SvenHaedrich/kicad_dali_usb_lpc/README.md

KiCad Project for DALI to USB interface based on NXP LPC 1114 µController.

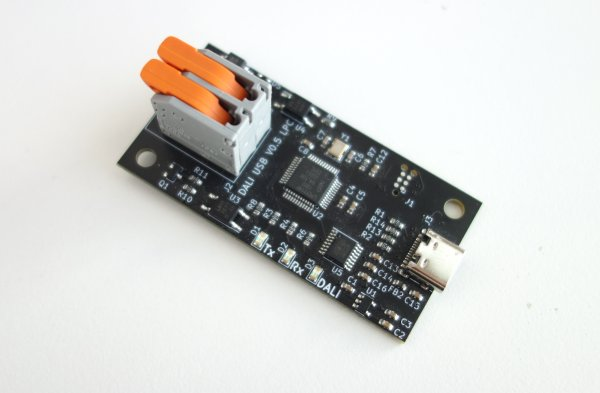
[picture p1: docs/DSC06797.JPG]
