SvenHaedrich/kicad_dali_usb_lpc/docs/transient_times.odt

Observed signal transient times are in the order of 10 ns. Both for falling and rising edges.

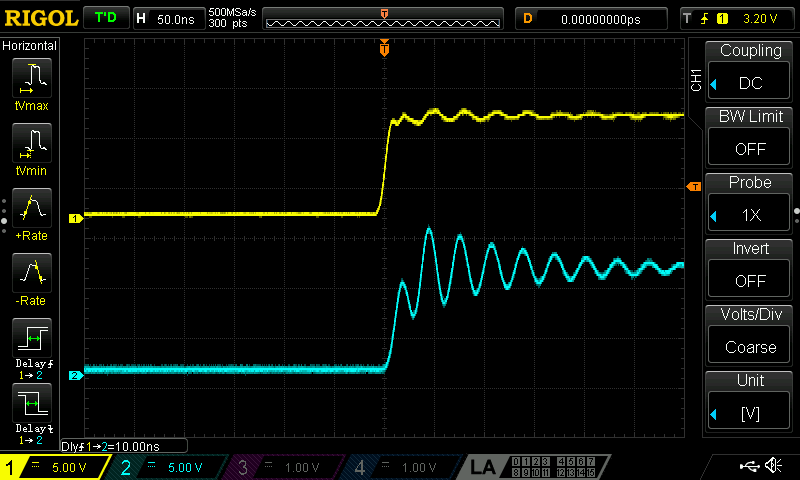
[picture p2: figure]

Figure 1: Rising edge test. Channel 1: signal generator. Channel 2: Testec probe.

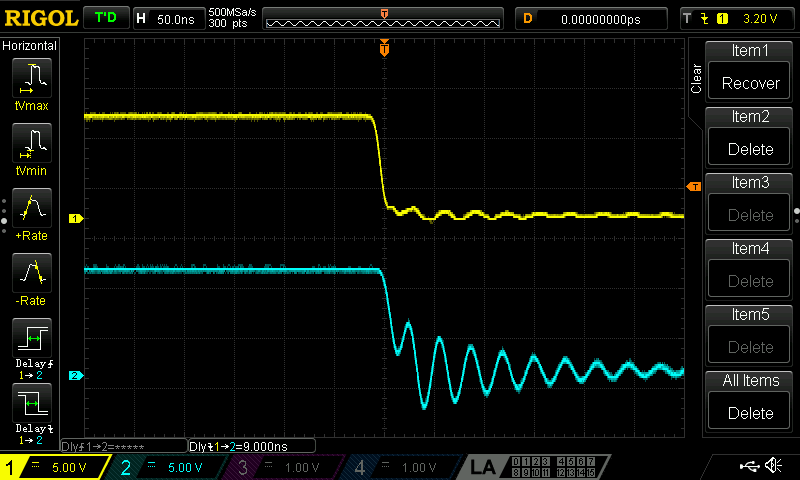
[picture p3: figure]

Figure 2: Falling edge test. Channel 1: signal generator, Channel 2: Testec probe

Rx transient times: falling edge: 21.8 µs, rising edge: 4.15 µs

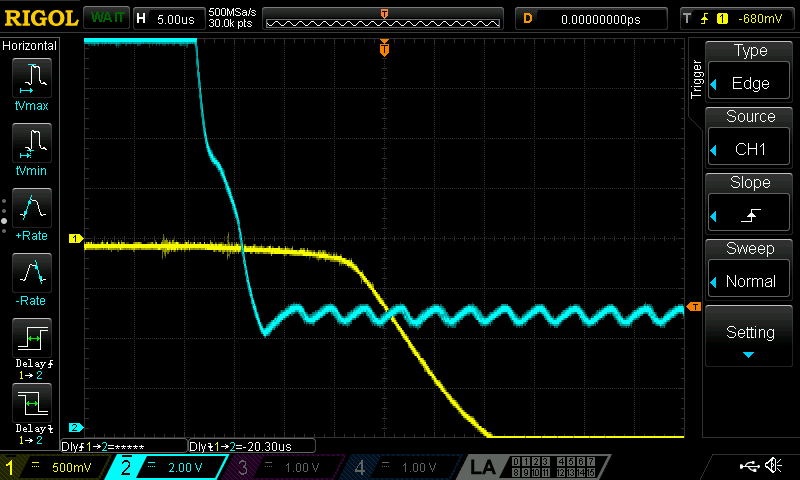
[picture p4: figure]

Figure 3: Rx falling edge transient time: 21.8 µs, channel 1: pin OC, channel 2: DALI bus

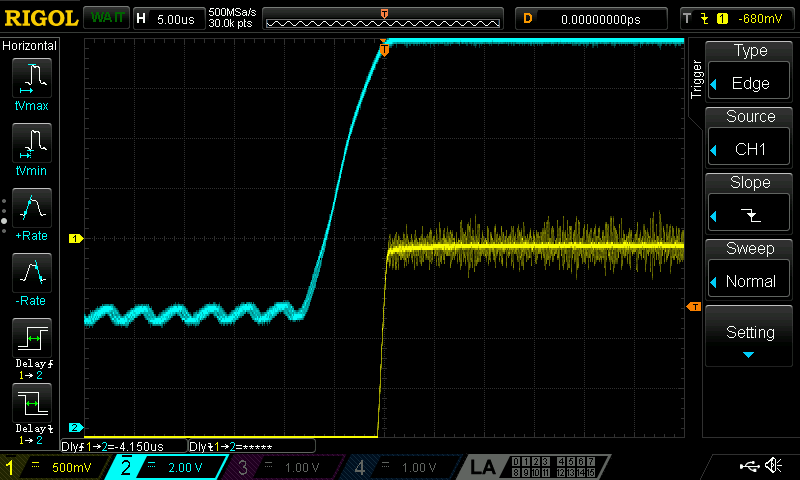
[picture p5: figure]

Figure 4: Rx rising edge transient time: 4.15 µs, channel 1: pin OC, channel 2: DALI bus

Pulses on the Rx line are 21.8 µs – 4.15 µs = 17.65 µs shorter than those on the DALI bus

Tx transient times: 17.6 µs – 3.85 µs

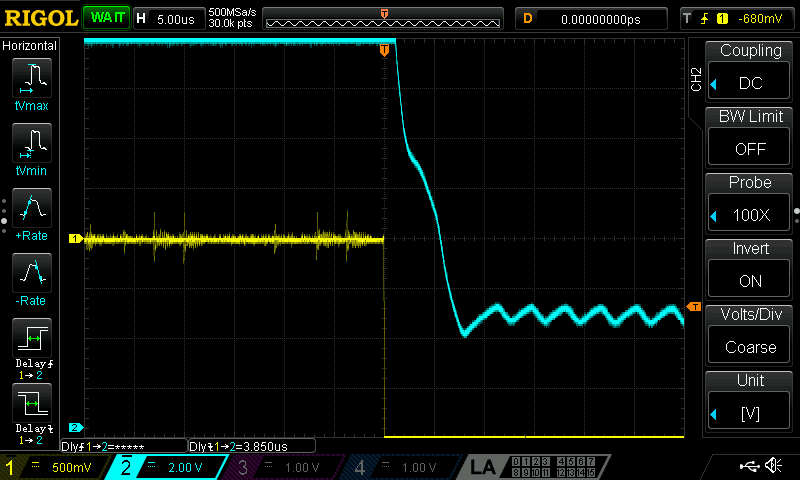
[picture p6: figure]

Figure 5: Tx falling edge transient time: 3.85 µs

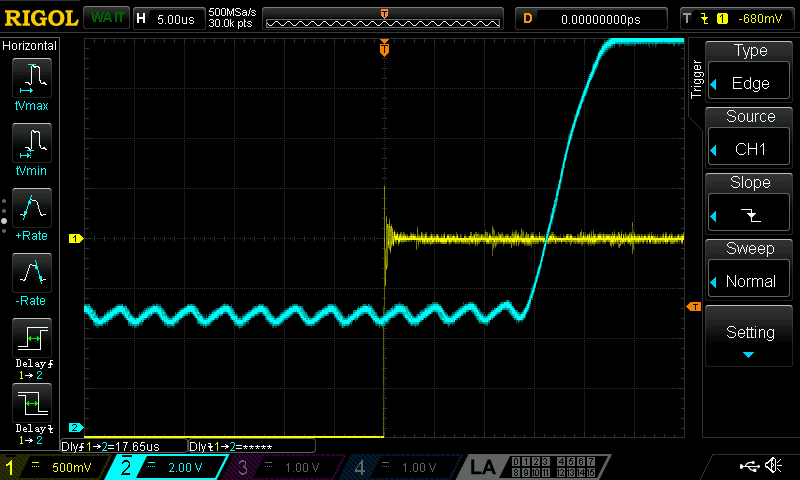
[picture p7: figure]

Figure 6: Tx rising edge transient time: 17.65 µs

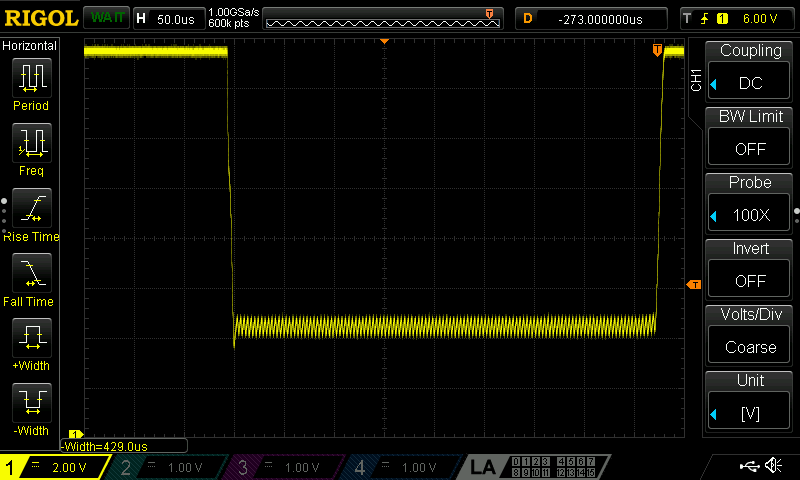
[picture p8: figure]

Figure 7: Pulse on DALI bus, not corrected, nominal pulsewidth 416 µs
