SvenHaedrich/kicad_dali_usb_lpc/docs/DALI_USB_3D.png

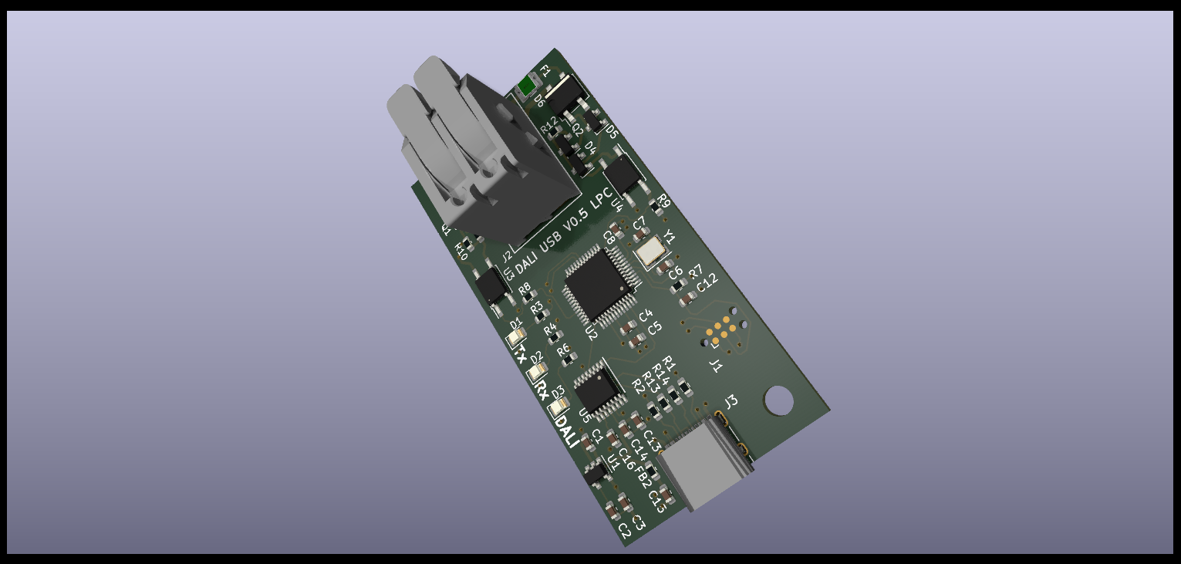
docs/DALI_USB_3D.png
