SvenHaedrich/kicad_dali_usb_lpc/hardware/cad/HRO  TYPE-C-31-M-12.step

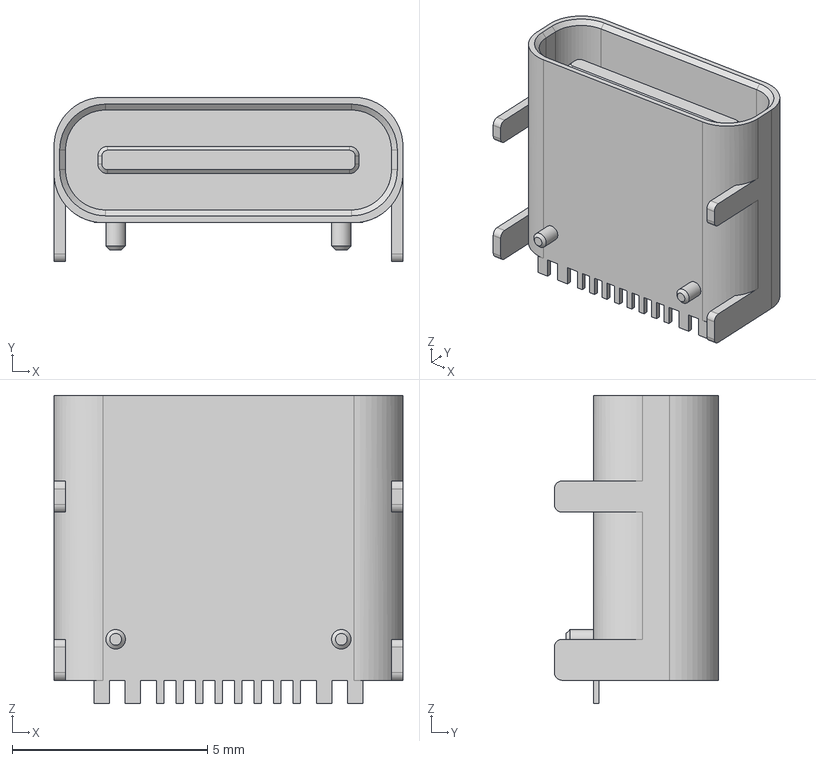
[picture p10: CAD file, 2022-10-16]
hardware/cad/HRO TYPE-C-31-M-12.step
8.94 x 4.21 x 7.90 mm
