SvenHaedrich/kicad_dali_usb_lpc/hardware/cad/SMD_Polyfuse_1210.stp

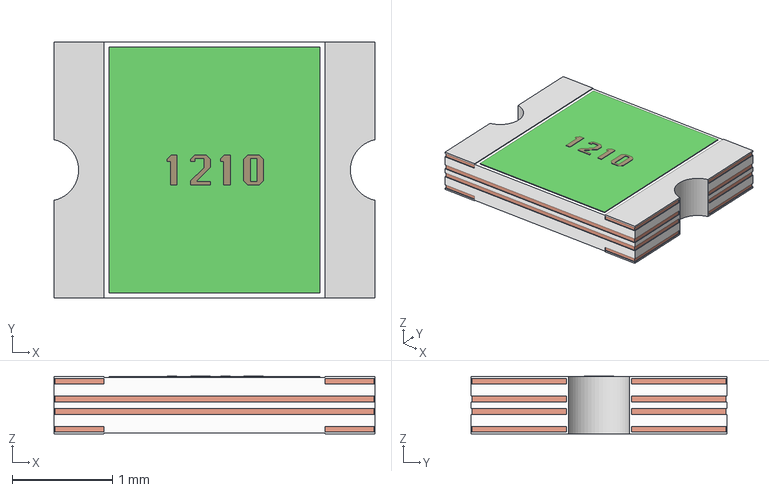
[picture p11: CAD file, 2022-10-16]
hardware/cad/SMD_Polyfuse_1210.stp
3.20 x 2.55 x 0.575 mm
