SvenHaedrich/kicad_dali_usb_lpc/docs/DALI_USB.pdf

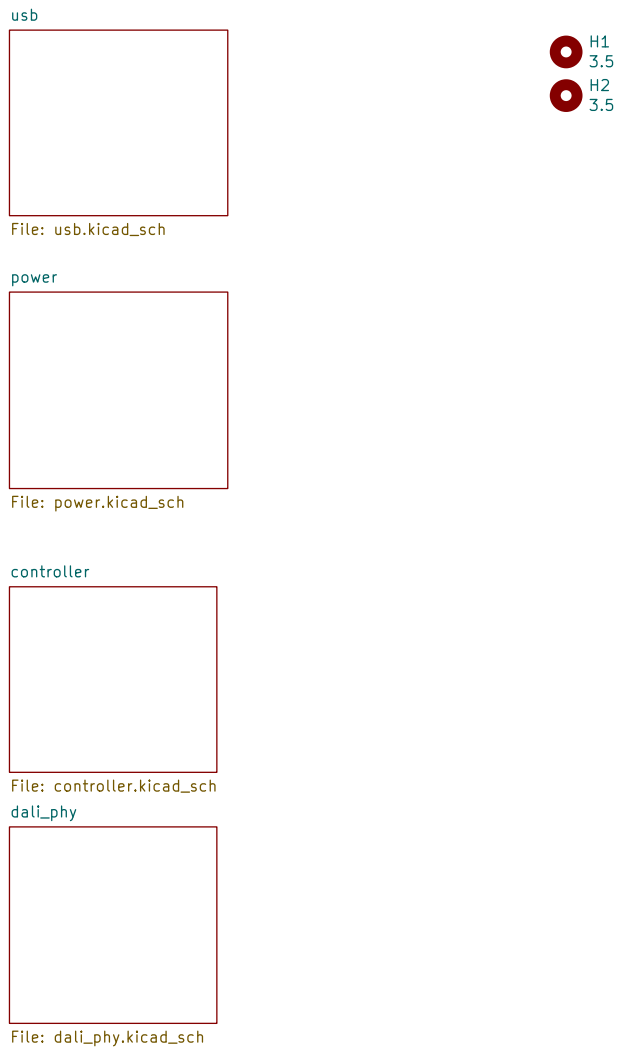
[picture p12: page 1]

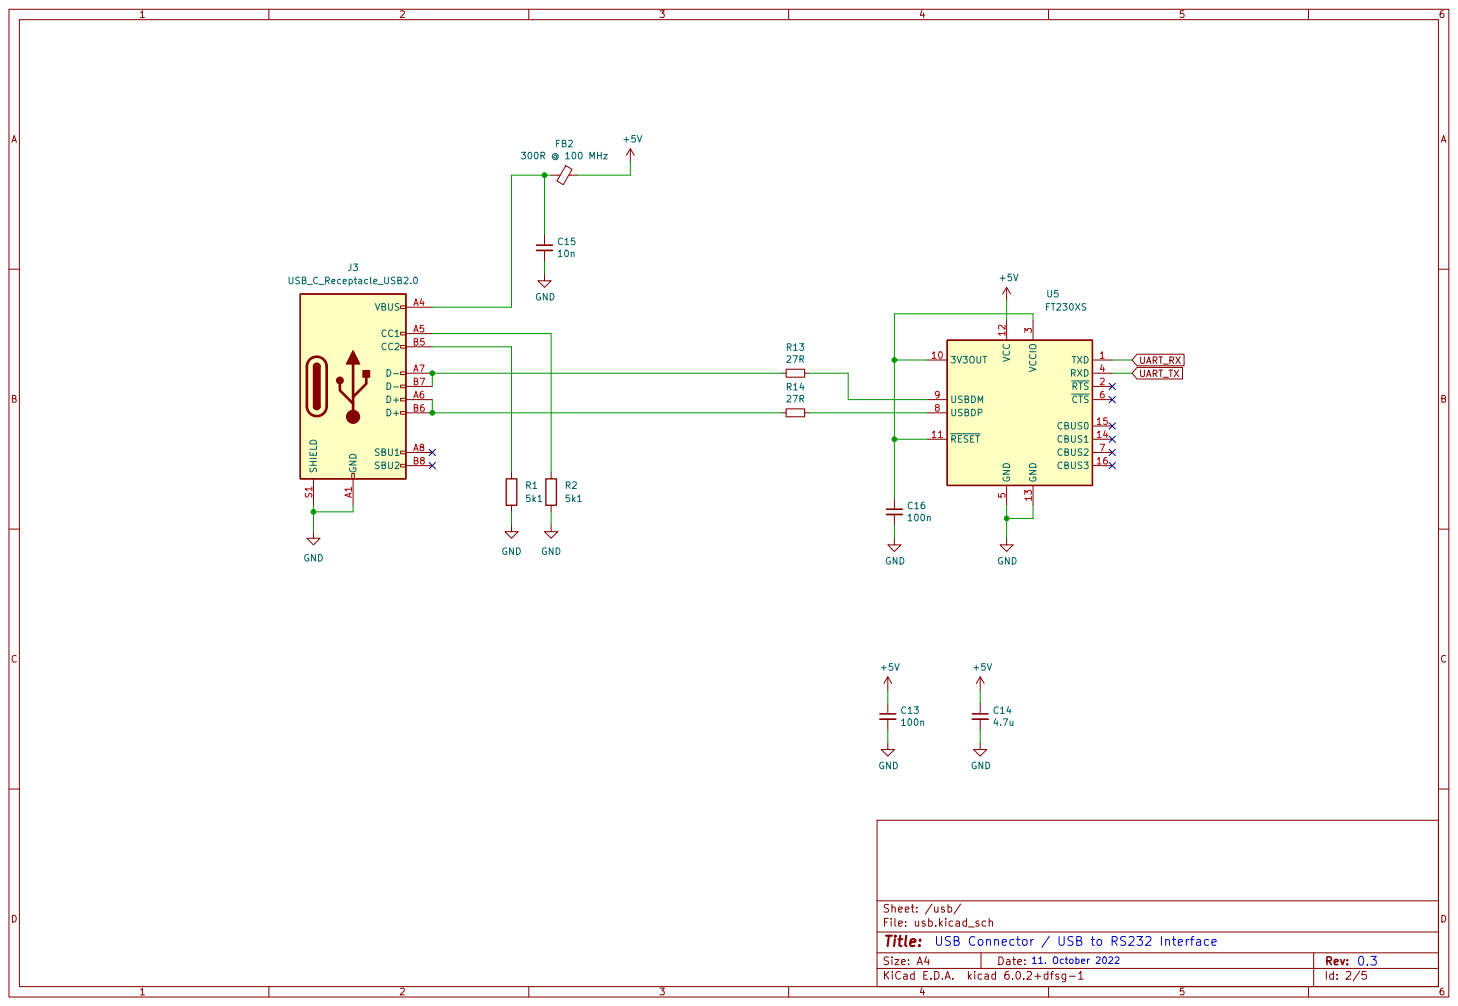
[picture p13: page 2]

USB Connector / USB to RS232 Interface

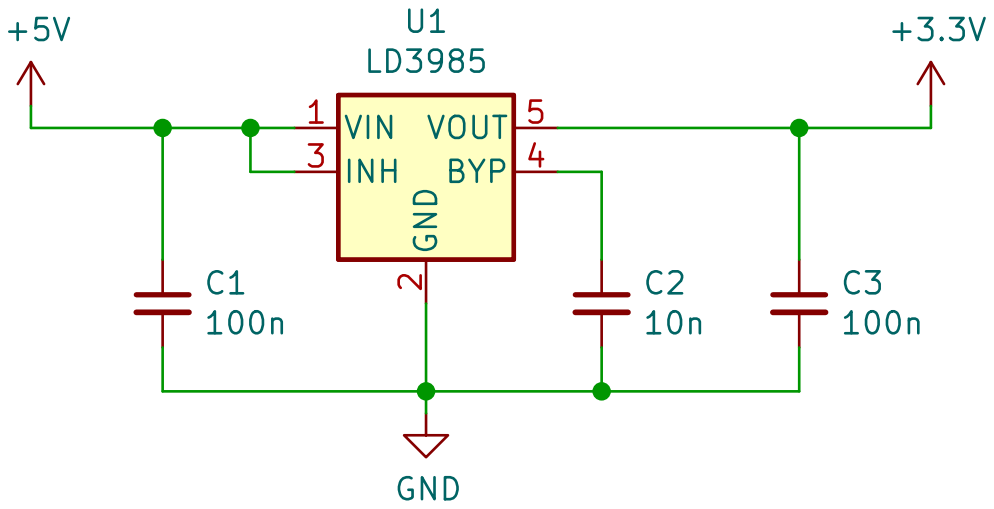
[picture p14: page 3]

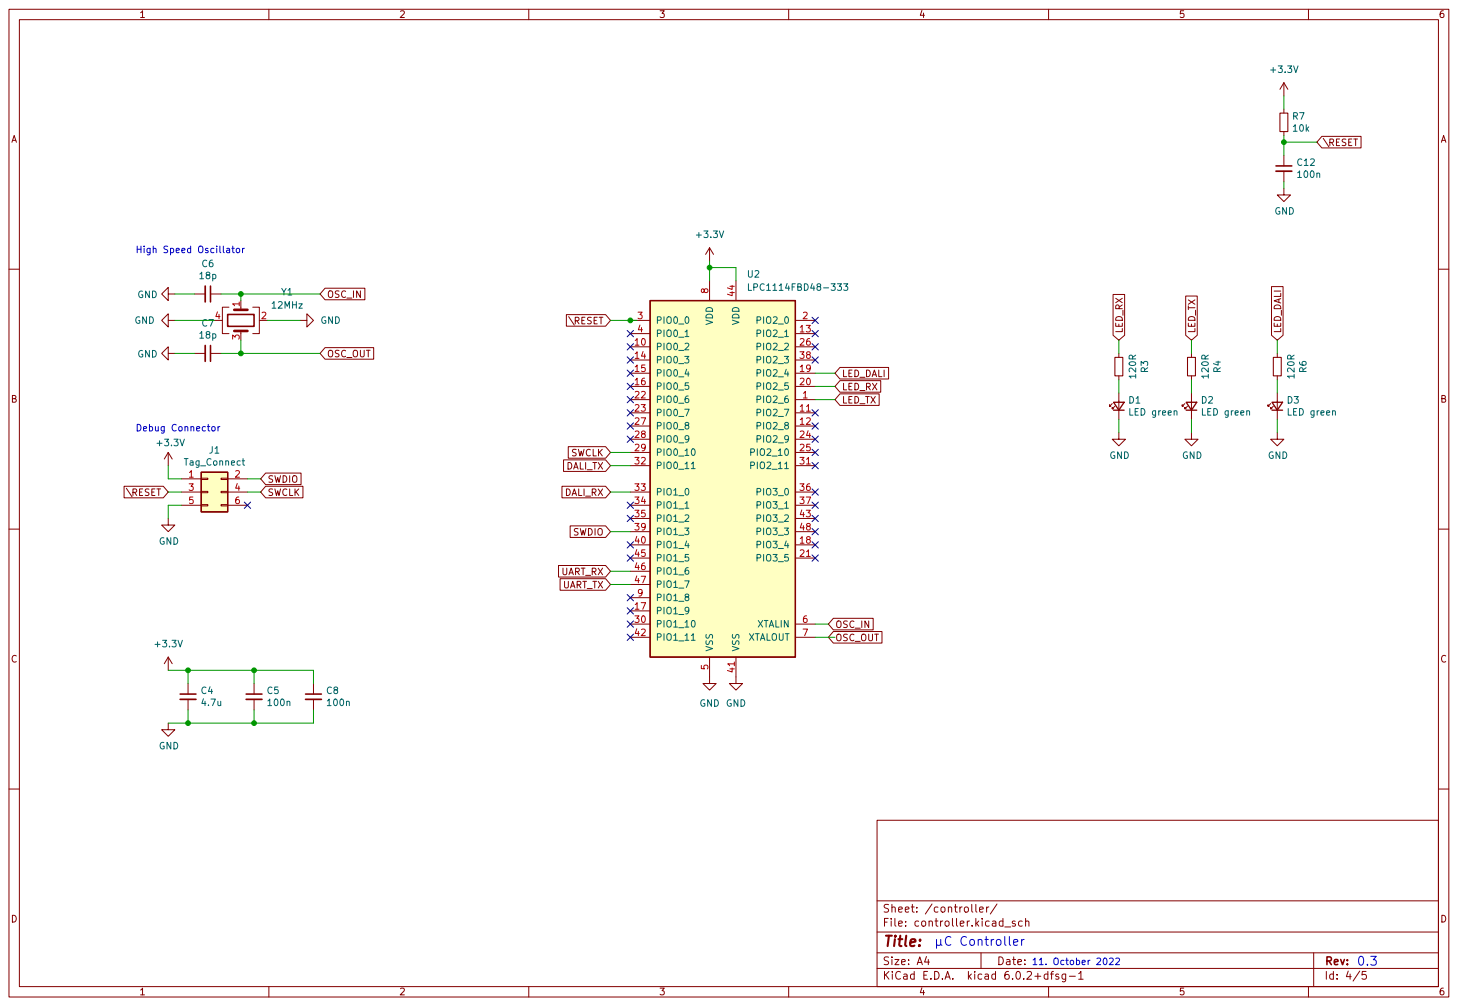
[picture p15: page 4]

File: controller.kicad_sch Sheet: /controller/
Id: 4/5 Title:

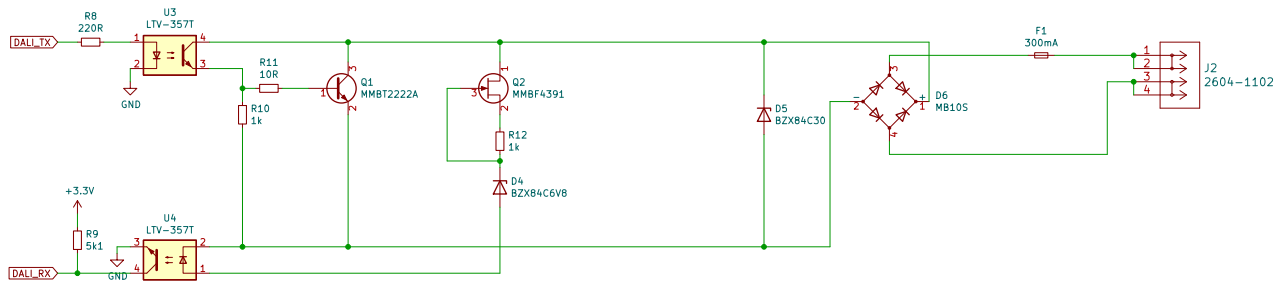
[picture p16: page 5]
