SvenHaedrich/kicad_dali_usb_lpc/hardware/DALI_USB.kicad_pcb

## KiCad design hardware/DALI_USB.kicad_pcb (2022-10-16)

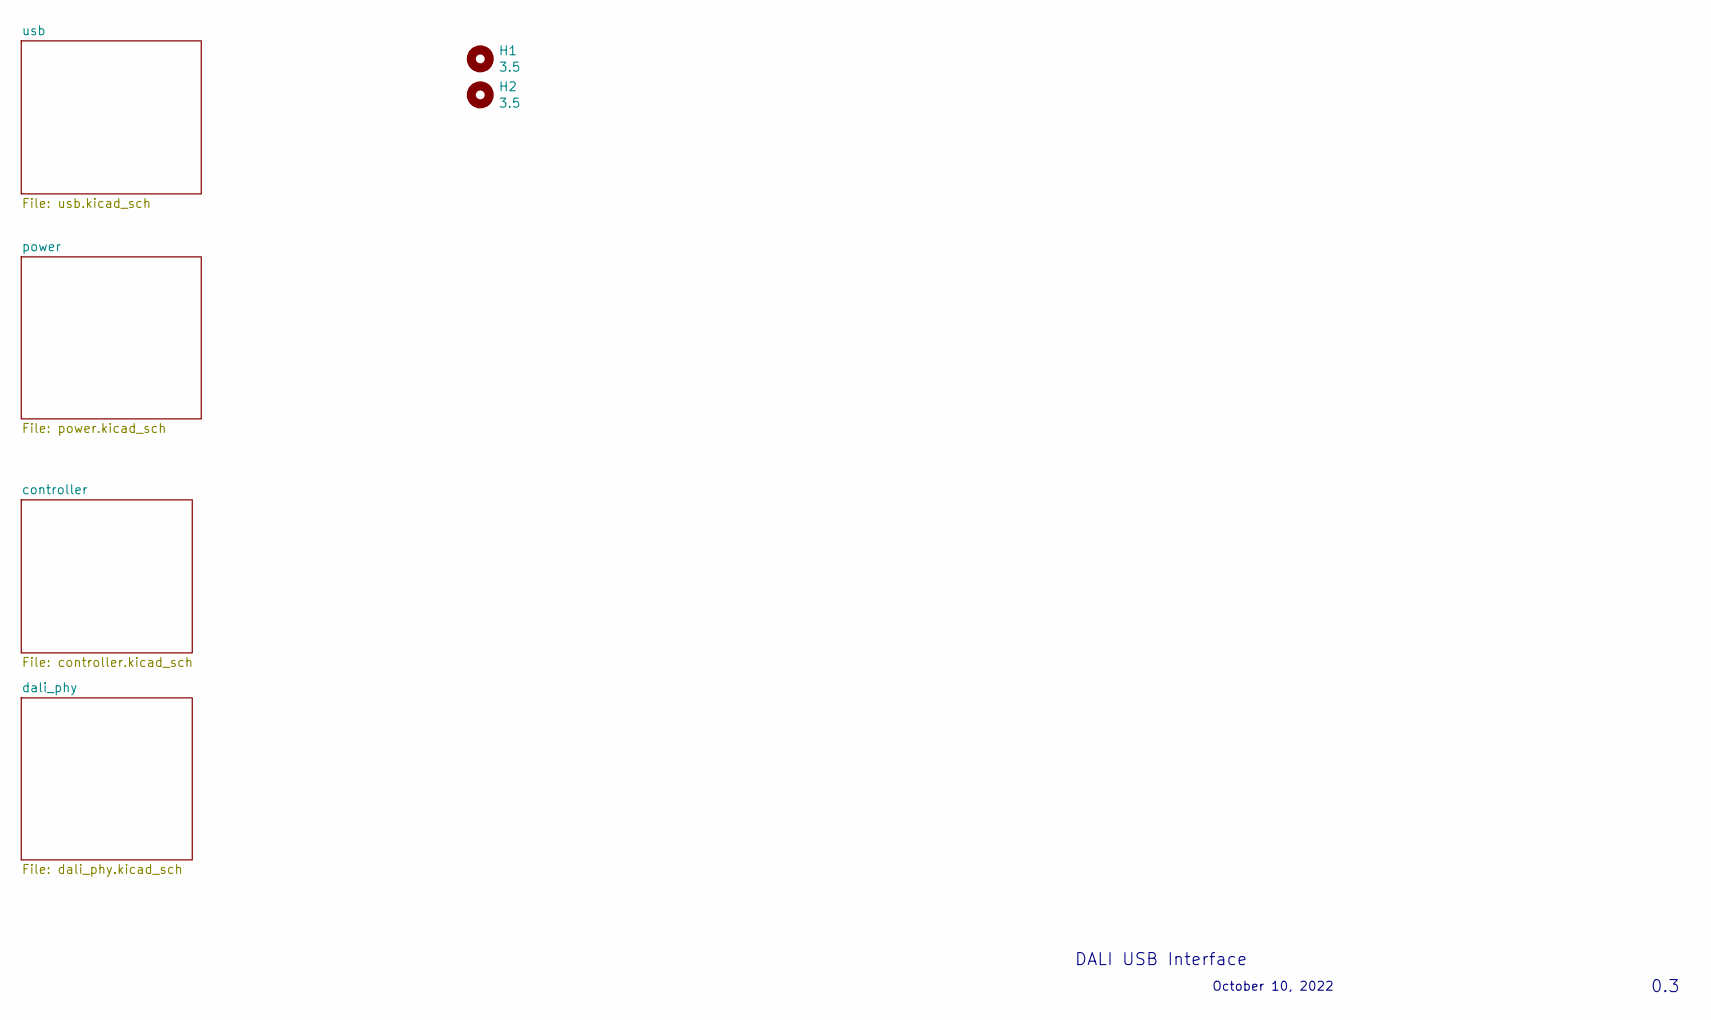
[picture p17: schematic DALI_USB.kicad_sch]

Parts:
H1, H2: 3.5; MountingHole_3.5mm

Notes on the sheet:
DALI USB Interface
October 10, 2022
0.3

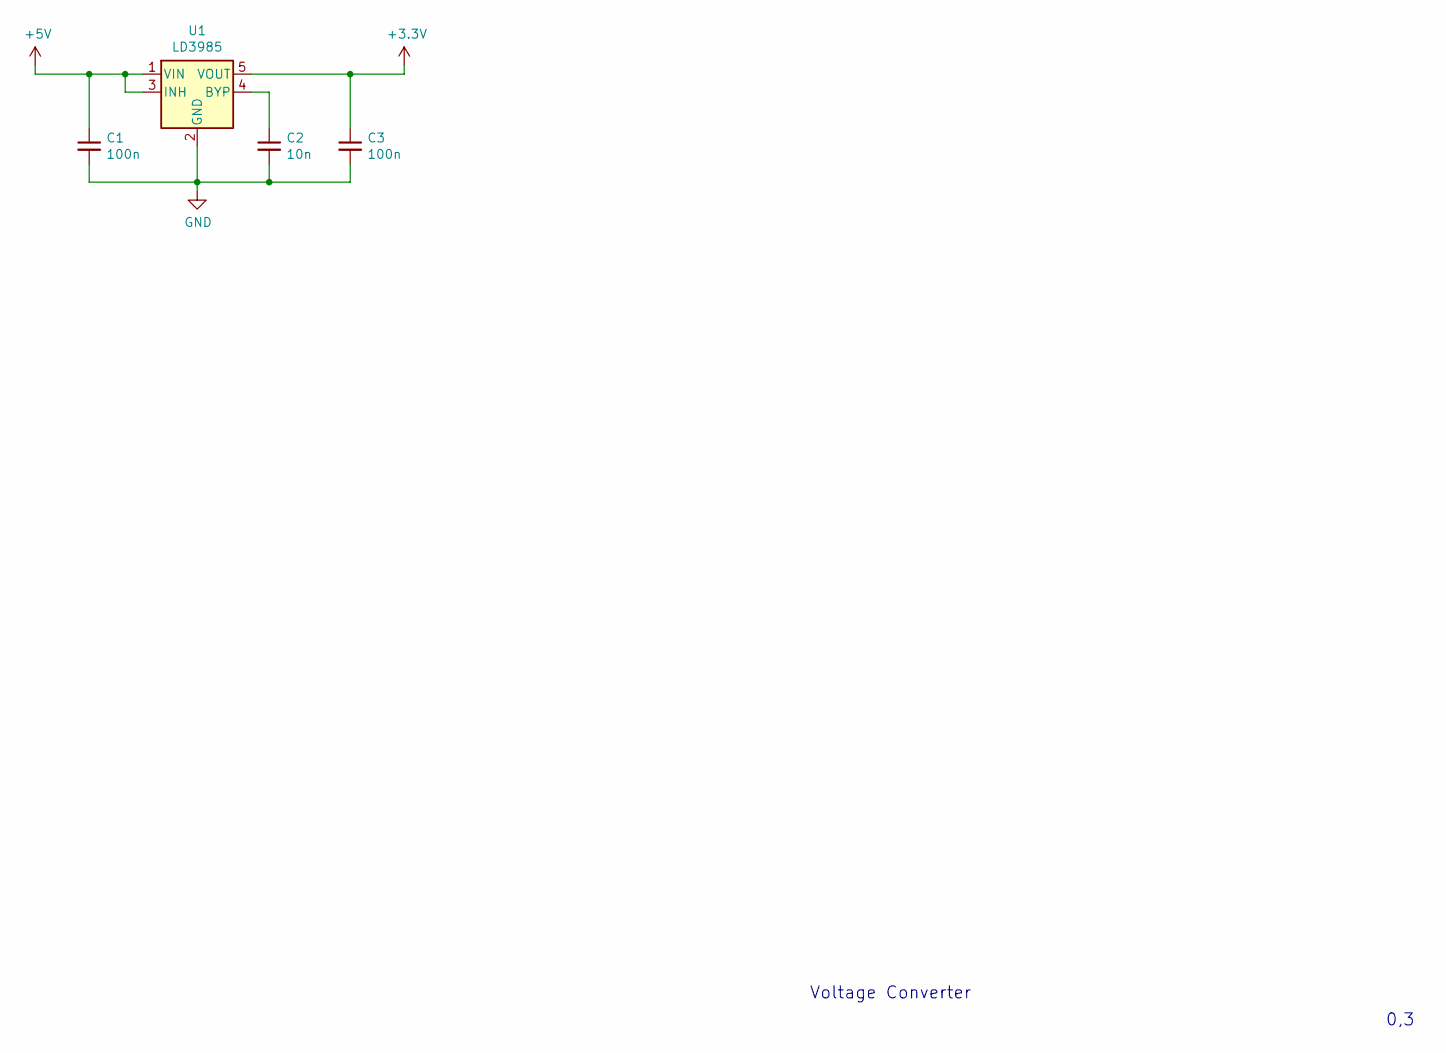
[picture p18: schematic power.kicad_sch]

Parts:
C1, C3: 100n; C_0603_1608Metric; LCSC C14663
C2: 10n; C_0603_1608Metric; LCSC C57112
U1: LD3985; SOT-23-5; Digikey 497-3504-1-ND

Connections:
+3V3: C3.1, U1.5 (VOUT); also elsewhere on the board
+5V: C1.1, U1.1 (VIN), U1.3 (INH); also elsewhere on the board
GND: C1.2, C2.2, C3.2, U1.2 (GND); also elsewhere on the board
unnamed: C2.1, U1.4 (BYP)

Notes on the sheet:
0,3
Voltage Converter

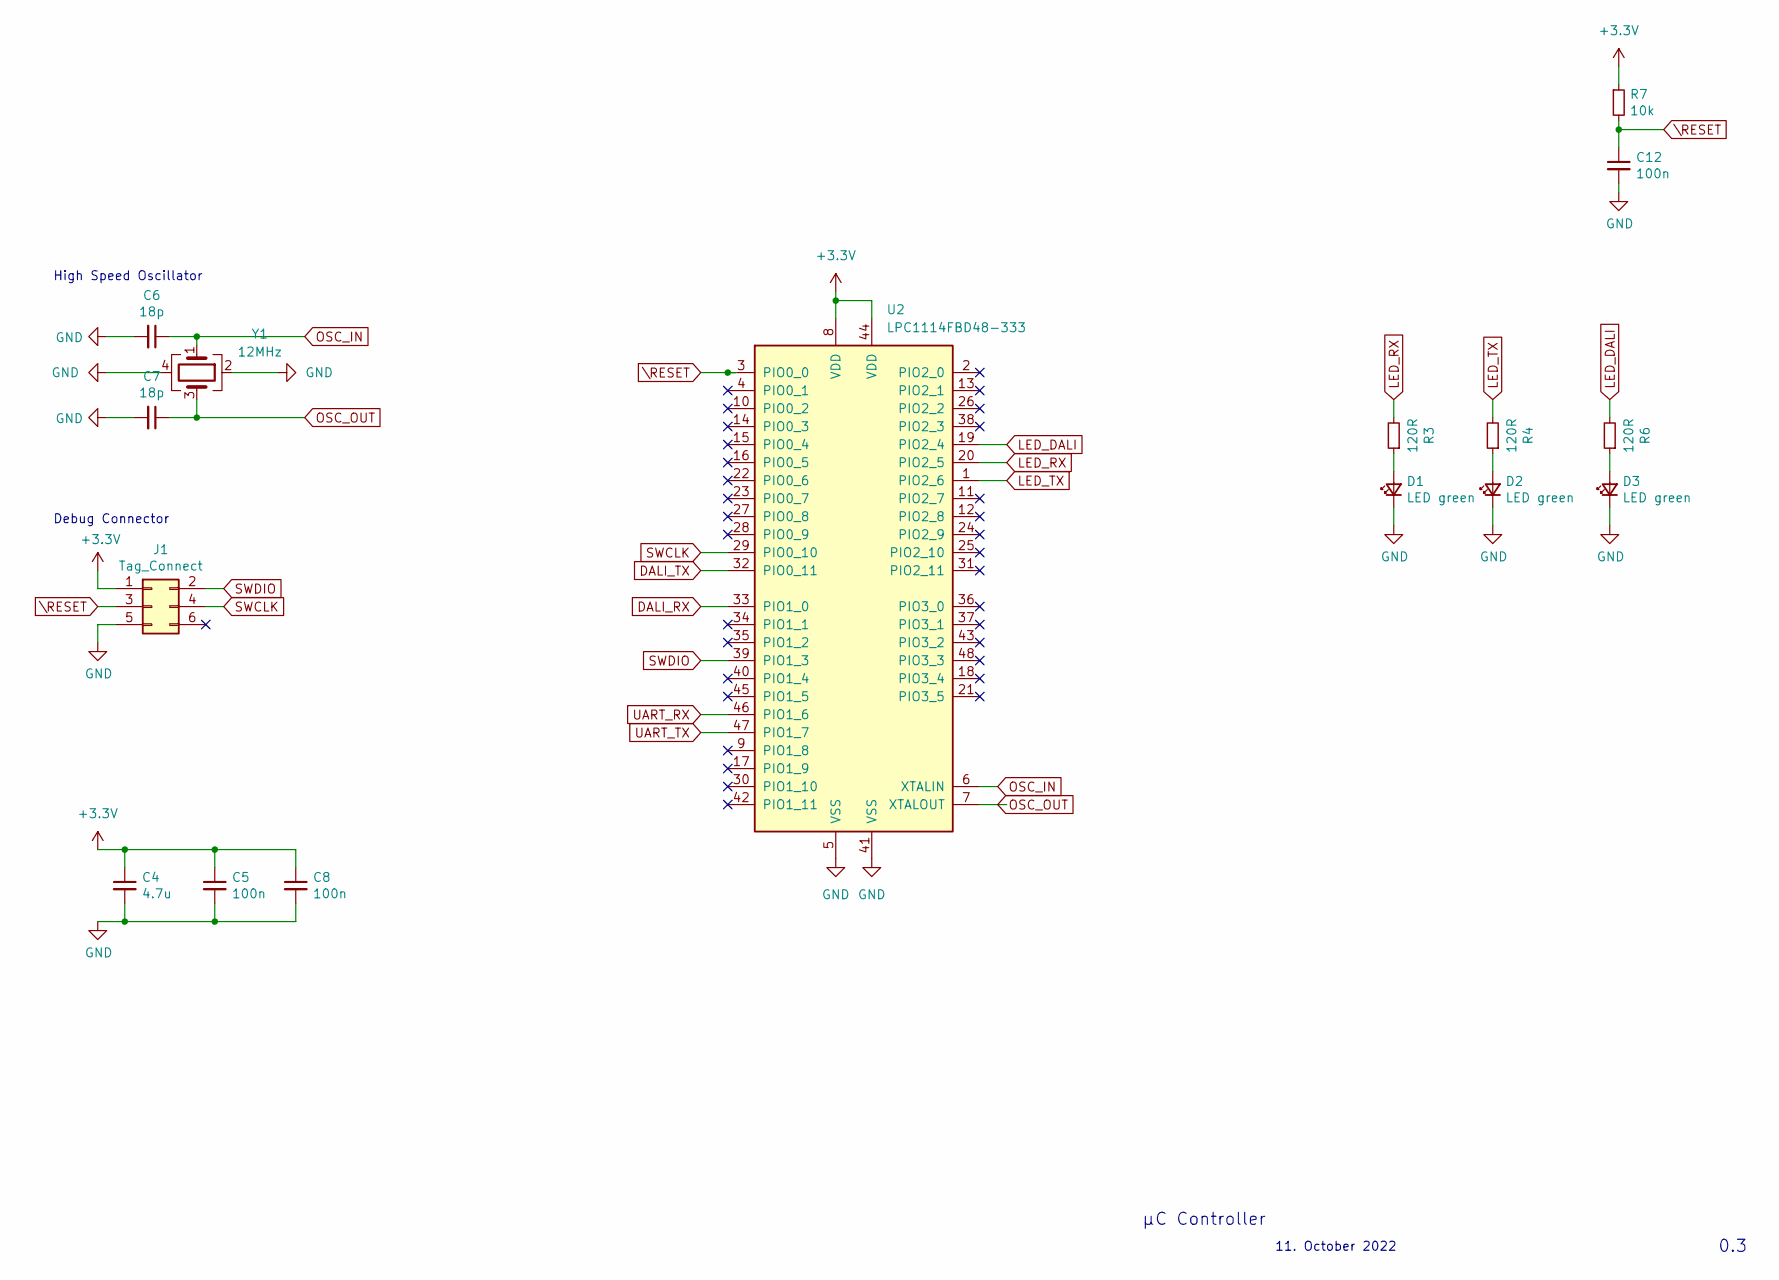
[picture p19: schematic controller.kicad_sch]

Parts:
C4: 4.7u; C_0603_1608Metric; LCSC C19666
C5, C8, C12: 100n; C_0603_1608Metric; LCSC C14663
C6, C7: 18p; C_0603_1608Metric; LCSC C38523
D1, D2, D3: LED green; LED_0805_2012Metric; LCSC C98221
J1: Tag_Connect; Tag-Connect_TC2030-IDC-NL_2x03_P1.27mm_Vertical
R3, R4, R6: 120R; R_0603_1608Metric; LCSC C114640
R7: 10k; R_0603_1608Metric; LCSC C25804
U2: LPC1114FBD48-333; LQFP-48_7x7mm_P0.5mm; LCSC C9872
Y1: 12MHz; Crystal_SMD_TXC_7M-4Pin_3.2x2.5mm; LCSC C9002

Connections:
+3V3: C4.1, C5.1, C8.1, J1.1, R7.1, U2.8 (VDD), U2.44 (VDD); also elsewhere on the board
DALI_RX: U2.33 (PIO1_0); also elsewhere on the board
DALI_TX: U2.32 (PIO0_11); also elsewhere on the board
GND: C4.2, C5.2, C6.2, C7.2, C8.2, C12.2, D1.1 (K), D2.1 (K), D3.1 (K), J1.5, U2.5 (VSS), U2.41 (VSS), Y1.2, Y1.4; also elsewhere on the board
LED_DALI: R6.2, U2.19 (PIO2_4)
LED_RX: R3.2, U2.20 (PIO2_5)
LED_TX: R4.2, U2.1 (PIO2_6)
unnamed: D1.2 (A), R3.1
unnamed: D2.2 (A), R4.1
unnamed: D3.2 (A), R6.1
OSC_IN: C6.1, U2.6 (XTALIN), Y1.1
OSC_OUT: C7.1, U2.7 (XTALOUT), Y1.3
SWCLK: J1.4, U2.29 (PIO0_10)
SWDIO: J1.2, U2.39 (PIO1_3)
UART_RX: U2.46 (PIO1_6); also elsewhere on the board
UART_TX: U2.47 (PIO1_7); also elsewhere on the board
\RESET: C12.1, J1.3, R7.2, U2.3 (PIO0_0)

Notes on the sheet:
Debug Connector
11. October 2022
High Speed Oscillator
µC Controller
0.3

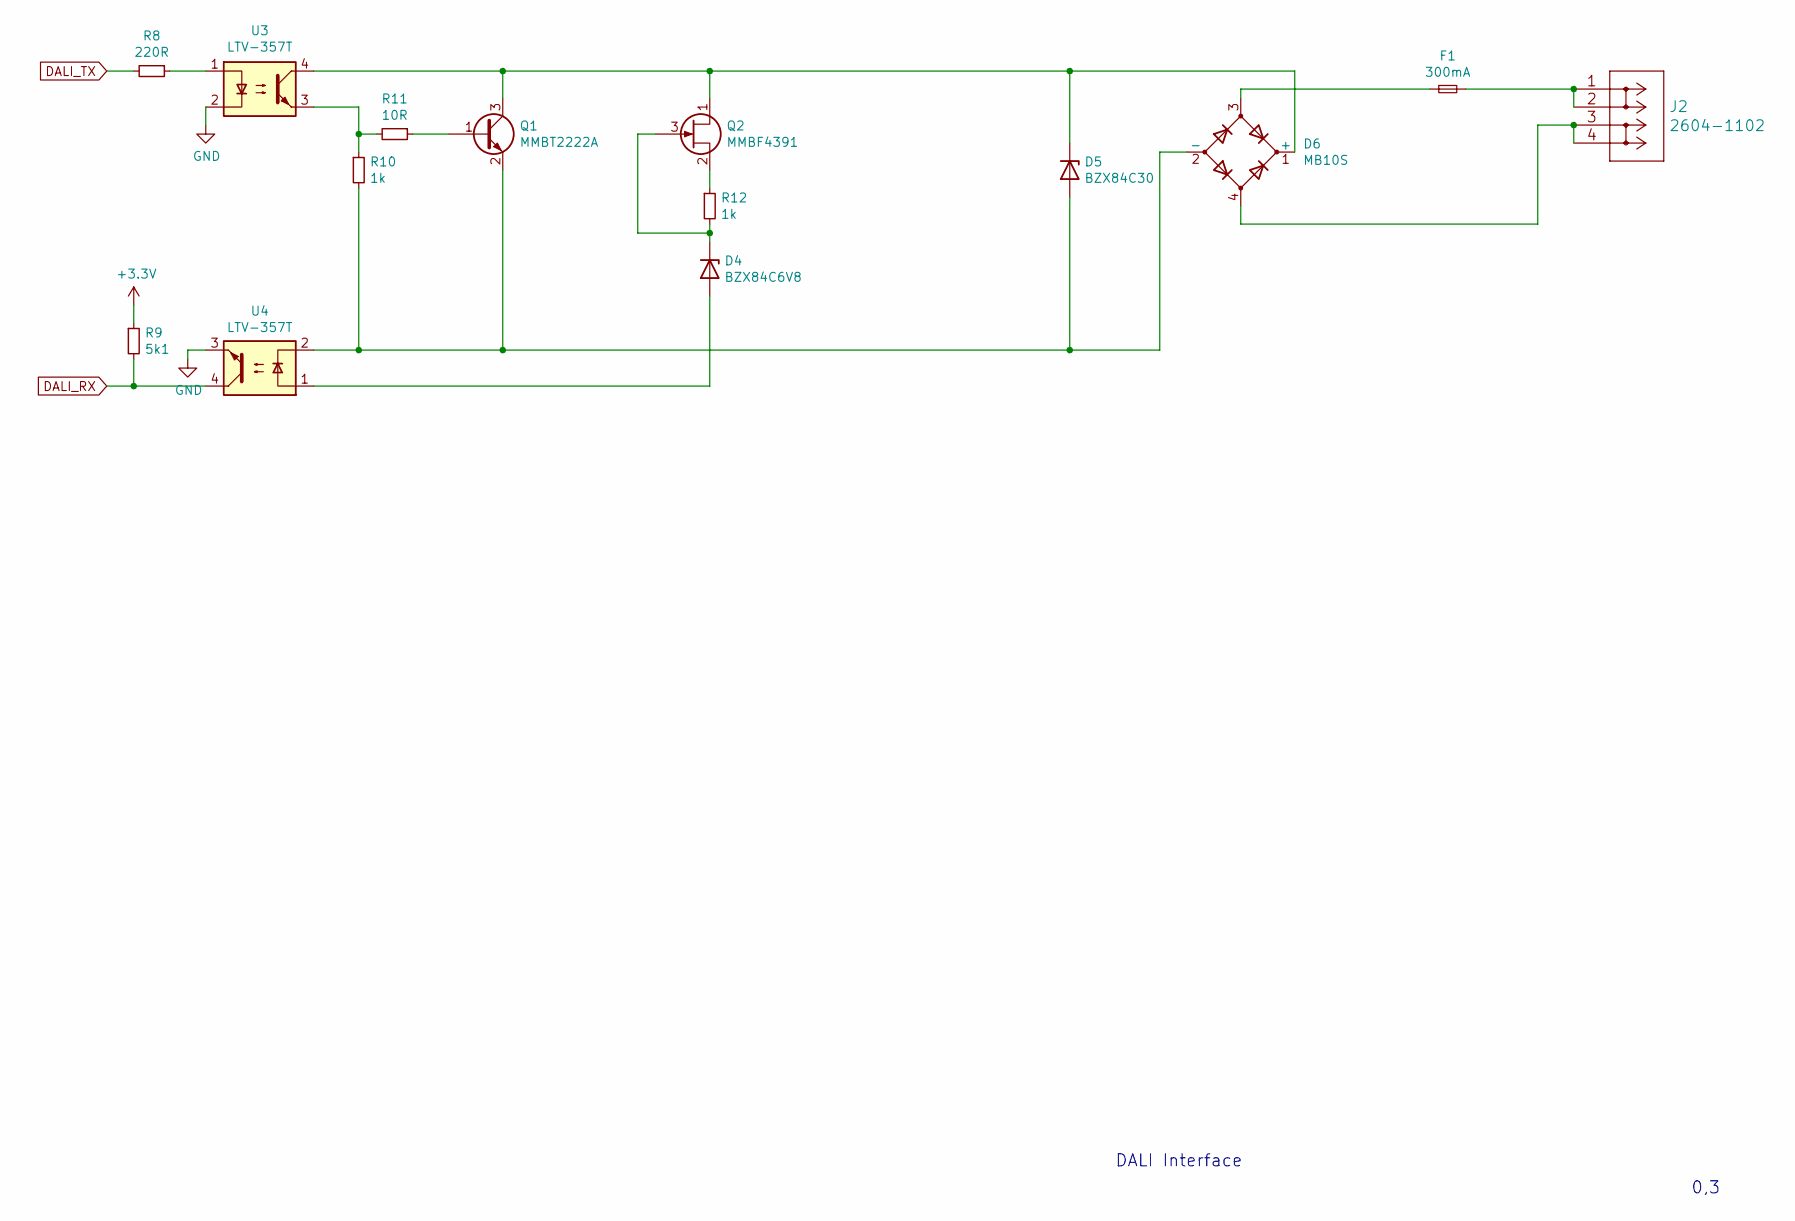
[picture p20: schematic dali_phy.kicad_sch]

Parts:
D4: BZX84C6V8; D_SOT-23_ANK; Digikey BZX84C3V9FSCT-ND
D5: BZX84C30; D_SOT-23_ANK; Digikey 112-BZX84C30-E3-08CT-ND
D6: MB10S; TO-269AA; Digikey MB4SCT-ND
F1: 300mA; Fuse_1210_3225Metric; LCSC C70086
J2: 2604-1102
Q1: MMBT2222A; SOT-23; Digikey MMBT5550LT3G
Q2: MMBF4391; SOT-23; LCSC C153770
R8: 220R; R_0603_1608Metric; LCSC C22962
R9: 5k1; R_0603_1608Metric; LCSC C365441
R10, R12: 1k; R_0603_1608Metric; LCSC C21190
R11: 10R; R_0603_1608Metric; LCSC C22859
U3, U4: LTV-357T; SO-4_4.4x3.6mm_P2.54mm; Digikey LTV-357T

Connections:
+3V3: R9.1; also elsewhere on the board
DALI_RX: R9.2, U4.4; also elsewhere on the board
DALI_TX: R8.2; also elsewhere on the board
GND: U3.2, U4.3; also elsewhere on the board
unnamed: D4.1 (K), Q2.3 (G), R12.2
unnamed: D4.2 (A), U4.1
unnamed: D5.1 (K), D6.1 (+), Q1.3 (C), Q2.1 (D), U3.4
unnamed: D5.2 (A), D6.2 (-), Q1.2 (E), R10.2, U4.2
unnamed: D6.3, F1.1
unnamed: D6.4, J2.3, J2.4
unnamed: F1.2, J2.1, J2.2
unnamed: Q1.1 (B), R11.1
unnamed: Q2.2 (S), R12.1
unnamed: R8.1, U3.1
unnamed: R10.1, R11.2, U3.3

Notes on the sheet:
DALI Interface
0,3

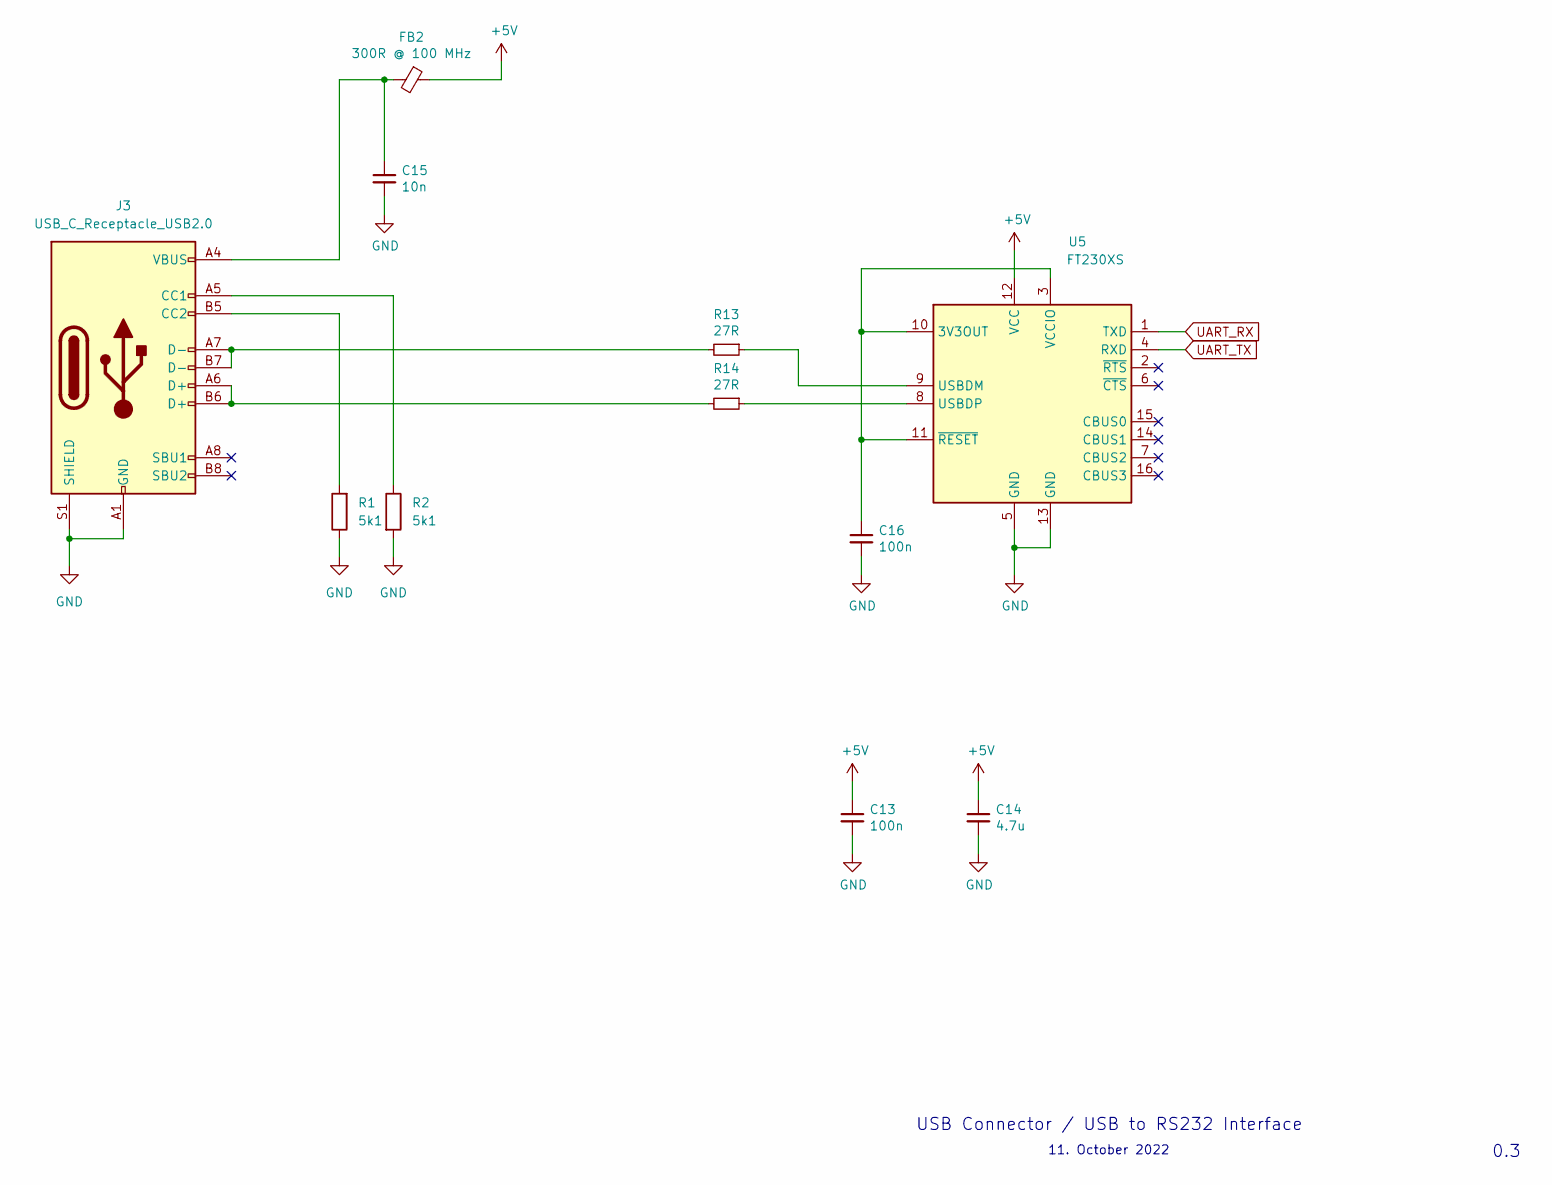
[picture p21: schematic usb.kicad_sch]

Parts:
C13, C16: 100n; C_0603_1608Metric; LCSC C14663
C14: 4.7u; C_0603_1608Metric; LCSC C19666
C15: 10n; C_0603_1608Metric; LCSC C57112
FB2: 300R @ 100 MHz; R_0603_1608Metric; Digikey LBR29012T100M
J3: USB_C_Receptacle_USB2.0; USB_C_Receptacle_XKB_U262-16XN-4BVC11; LCSC C2987386
R1, R2: 5k1; R_0603_1608Metric; LCSC C365441
R13, R14: 27R; R_0603_1608Metric; LCSC C25190
U5: FT230XS; SSOP-16_3.9x4.9mm_P0.635mm; Digikey 768-1135-6-ND

Connections:
+5V: C13.1, C14.1, FB2.1, U5.12 (VCC); also elsewhere on the board
GND: C13.2, C14.2, C15.2, C16.2, J3.A1 (GND), J3.A12 (GND), J3.B1 (GND), J3.B12 (GND), J3.S1 (SHIELD), R1.1, R2.2, U5.5 (GND), U5.13 (GND); also elsewhere on the board
unnamed: C15.1, FB2.2, J3.A4 (VBUS), J3.A9 (VBUS), J3.B4 (VBUS), J3.B9 (VBUS)
unnamed: C16.1, U5.3 (VCCIO), U5.10 (3V3OUT), U5.11 (~RESET)
unnamed: J3.A5 (CC1), R2.1
unnamed: J3.B5 (CC2), R1.2
unnamed: J3.A7 (D-), J3.B7 (D-), R13.2
unnamed: J3.A6 (D+), J3.B6 (D+), R14.2
unnamed: R14.1, U5.8 (USBDP)
unnamed: R13.1, U5.9 (USBDM)
UART_RX: U5.1 (TXD); also elsewhere on the board
UART_TX: U5.4 (RXD); also elsewhere on the board

Notes on the sheet:
11. October 2022
USB Connector / USB to RS232 Interface
0.3

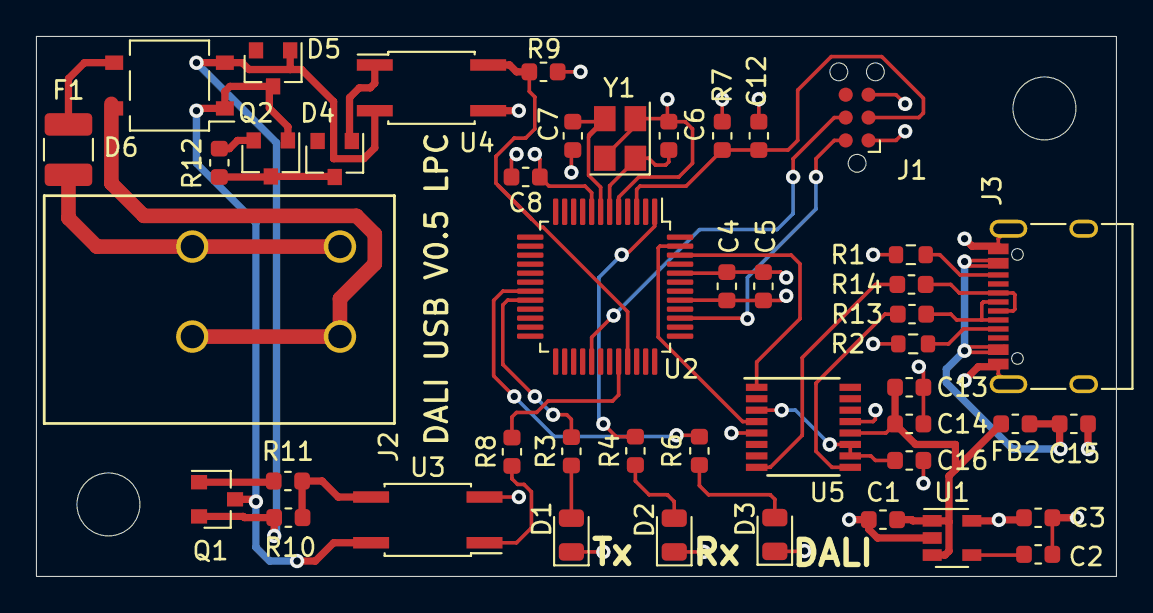
[picture p22: board DALI_USB.kicad_pcb from above]

Board: 4 copper layers, 60.0 x 30.0 mm, 47 parts (0 on the bottom side), 38 nets.
