SvenHaedrich/kicad_dali_usb_lpc/(commit log)

2022-10-16 second commit
    [DALI_USB.kicad_pcb, DALI_USB.kicad_sch, DALI_USB.sch, SMD_Polyfuse_1210.stp, controller.kicad_sch, controller.sch, dali_phy.kicad_sch, dali_phy.sch]
2022-10-16 change path for datasheets
    [controller.kicad_sch, dali_phy.kicad_sch, power.kicad_sch, usb.kicad_sch]
2022-10-16 move 3d files
    [SMD_Polyfuse_1210.stp]
2022-10-16 fix 3d models
    [2604-1102.stp, DALI_USB.kicad_pcb, HRO TYPE-C-31-M-12.step]
2022-10-16 add 3D view of pcb
2023-04-04 minor changes, add a picture of finished hardware
    [2604-1102.stp]
